rizohector/Printed_Circuit_Design/2_channel_relay_module_Replica/Doc/Propuesta/top_view.jpg

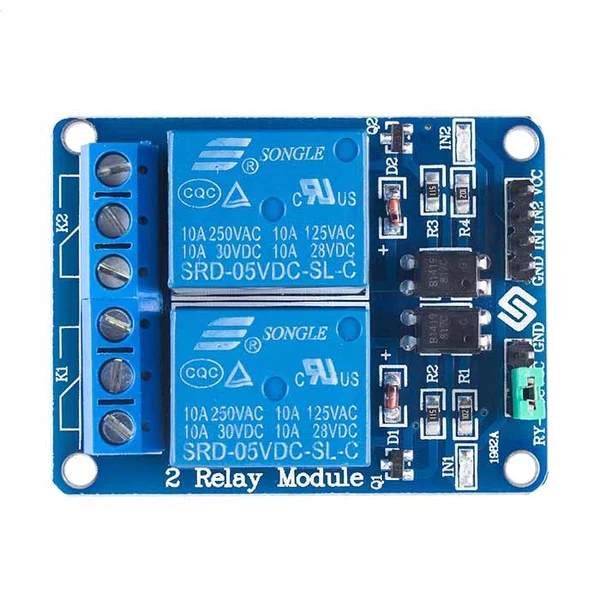
2_channel_relay_module_Replica/Doc/Propuesta/top_view.jpg
