rizohector/Printed_Circuit_Design/2_channel_relay_module_Replica/Doc/Datasheets/schematic.jpg

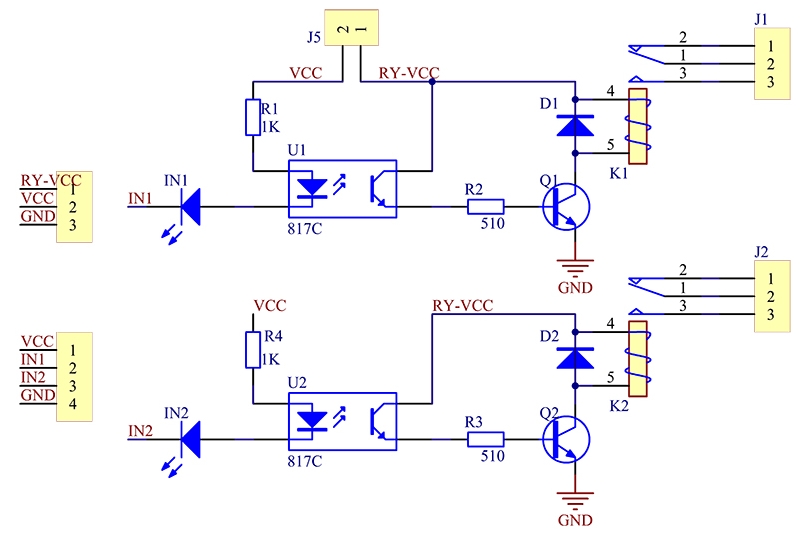
2_channel_relay_module_Replica/Doc/Datasheets/schematic.jpg
