rizohector/Printed_Circuit_Design/2_channel_relay_module_Replica/2_channel_relay_module/2_channel_relay_module.kicad_pcb

## KiCad design 2_channel_relay_module_Replica/2_channel_relay_module/2_channel_relay_module.kicad_pcb (2022-08-10)

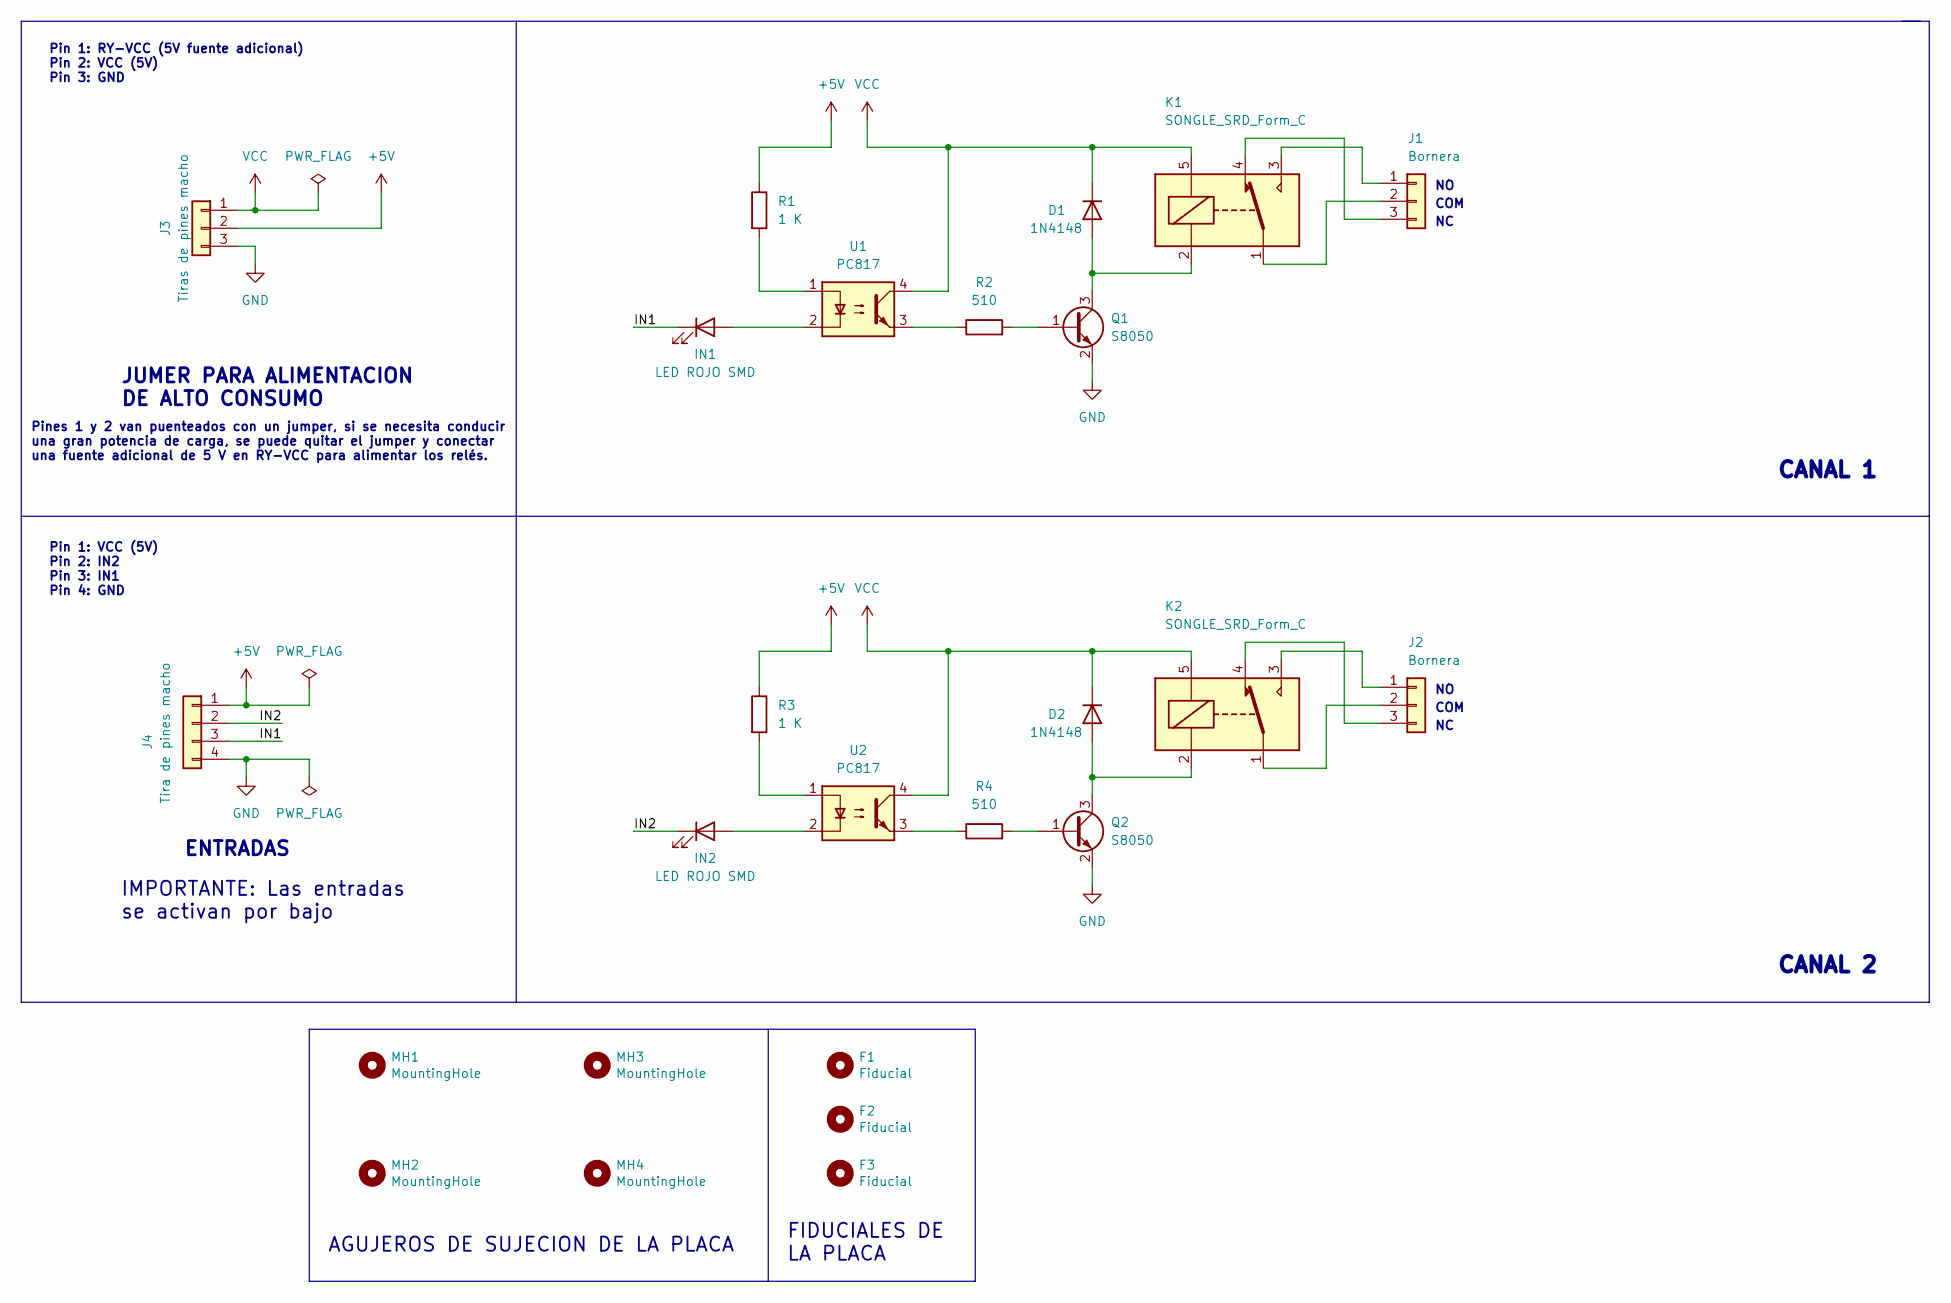
[picture p4: schematic 2_channel_relay_module.kicad_sch, Replica de módulo de relay de 2 canales]

Parts:
D1, D2: 1N4148; LED_1206_3216Metric
F1, F2, F3: Fiducial; Fiducial_0.5mm_Mask1.5mm
IN1, IN2: LED ROJO SMD; LED_1206_3216Metric
J1, J2: Bornera; TerminalBlock_bornier-3_P5.08mm
J3: Tiras de pines macho; PinHeader_1x03_P2.54mm_Vertical
J4: Tira de pines macho; PinHeader_1x04_P2.54mm_Vertical
K1, K2: SONGLE_SRD_Form_C; Relay_SPDT_SONGLE_SRD_Series_Form_C
MH1, MH2, MH3, MH4: MountingHole; MountingHole_3.2mm_M3_ISO14580
Q1, Q2: S8050; SOT-23
R1, R3: 1 K; R_1206_3216Metric
R2, R4: 510; R_1206_3216Metric
U1, U2: PC817; DIP-4_W7.62mm

Connections:
+5V: J3.2, J4.1, R1.1, R3.1
/IN1: IN1.1 (K), J4.3
/IN2: IN2.1 (K), J4.2
GND: J3.3, J4.4, Q1.2 (E), Q2.2 (E)
unnamed: D1.2 (A), K1.2, Q1.3 (C)
unnamed: D2.2 (A), K2.2, Q2.3 (C)
unnamed: IN1.2 (A), U1.2
unnamed: IN2.2 (A), U2.2
unnamed: J1.2, K1.1
unnamed: J2.2, K2.1
unnamed: J1.1, K1.3
unnamed: J1.3, K1.4
unnamed: J2.1, K2.3
unnamed: J2.3, K2.4
unnamed: Q1.1 (B), R2.2
unnamed: Q2.1 (B), R4.2
unnamed: R1.2, U1.1
unnamed: R2.1, U1.3
unnamed: R3.2, U2.1
unnamed: R4.1, U2.3
VCC: D1.1 (K), D2.1 (K), J3.1, K1.5, K2.5, U1.4, U2.4

Notes on the sheet:
CANAL 1
COM
Pines 1 y 2 van puenteados con un jumper, si se necesita conducir una gran potencia de carga, se puede quitar el jumper y conectar una fuente adicional de 5 V en RY-VCC para alimentar los relés.
JUMER PARA ALIMENTACION DE ALTO CONSUMO
ENTRADAS
FIDUCIALES DE LA PLACA
IMPORTANTE: Las entradas se activan por bajo
Pin 1: VCC (5V) Pin 2: IN2 Pin 3: IN1 Pin 4: GND
CANAL 2
AGUJEROS DE SUJECION DE LA PLACA
Pin 1: RY-VCC (5V fuente adicional) Pin 2: VCC (5V) Pin 3: GND

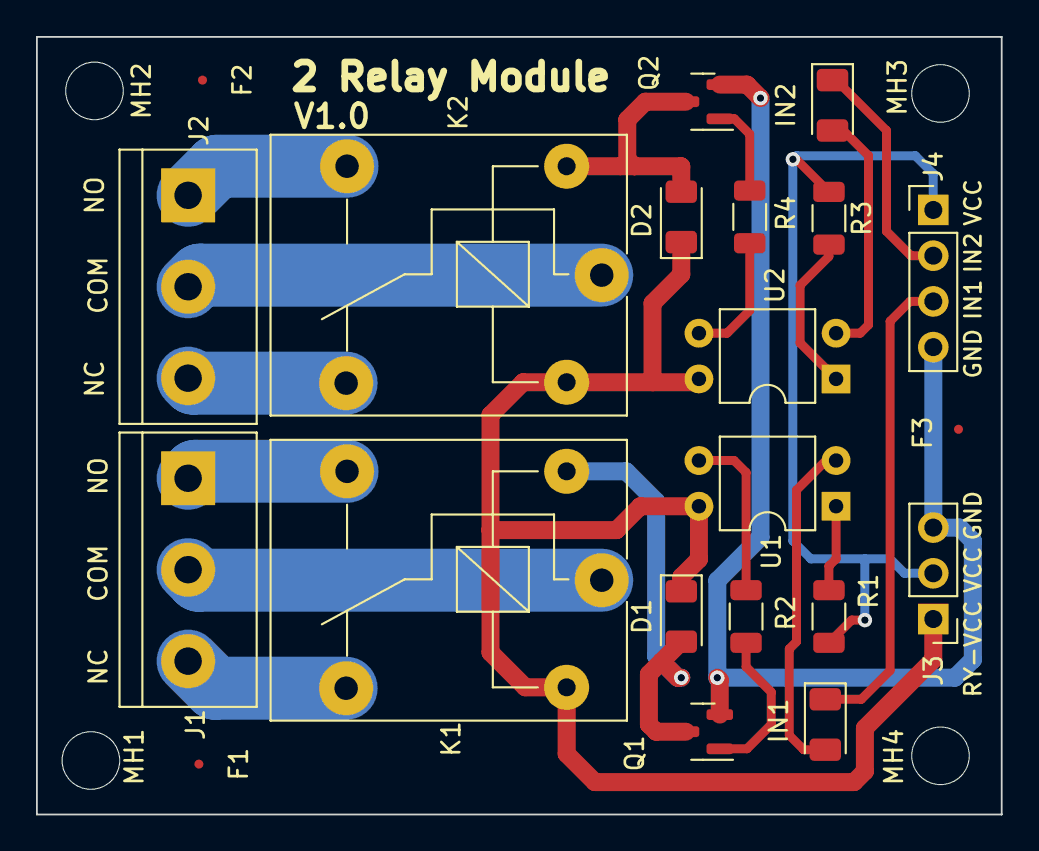
[picture p5: board 2_channel_relay_module.kicad_pcb from above]

Board: 2 copper layers, 53.6 x 43.2 mm, 25 parts (0 on the bottom side), 21 nets.
