rizohector/Printed_Circuit_Design/(notices)

Notices in the files:
2_channel_relay_module_Replica/2_channel_relay_module/2_channel_relay_module.kicad_sch:
Licencia: CERN OHL V1.0
